donetsss/kicad-base/(commit log)

2020-02-10 Added new mounting hole footprints.
2020-02-19 Added new capacitor library.
2020-02-19 Added TH 1mm test point.
2020-02-20 Changed polarity capacitor symbol.
2020-02-20 Added NSD05-12S5 meanwell power module.
2020-02-20 Changed connectors.
2020-02-21 Added analog ground.
2020-02-21 Added THP-4MR connector.
2020-02-23 Added Bourns 3329H potentiometer's footprint.
2020-03-07 New footprints added.
2020-04-01 Added WF-2 WF-3 connectors.
2020-04-01 Added new pin header and socket connectors.
2020-04-01 Added new mechanical holes.
2020-04-06 Added bom list libreoffice templates https://blog.radiotech.kz/programmy/generaciya-perechnya-ehlementov-v-kicad-po-gost/
2020-04-06 Added new axial capacitor.
2020-04-07 Added fuse.
2020-05-07 Added HMC221B RF Switch.
2020-05-07 Added STM32F103C8T6 MCU.
2020-05-16 Added DIN 41612 connector type B.
2020-06-05 Added mosfet library.
2020-12-04 Added USB_B_Micro connector reference.
2020-12-30 Added 2x06 pin header.
2022-03-07 Added all modified files for Kicad 5.
2022-03-07 Migrate to a new file format of kicad 6.
2023-06-22 Added WJ126-5.0R connectors.
2023-07-04 Added ningbo xy2500v-e-3.81-2p and xy2500v-e-3.81-3p connectors. Added jst xh-b4b and xh-s4b connectors.
2023-07-19 Added FS8205A double N type mosfet in TSSOP8.
2023-07-19 Added DW01A power protection unit for battery management systems.
2023-08-03 Added B4B-XH from JST connectors.
2023-08-12 Change STM32F407VG sch ref.
2023-10-07 Added NAIS DSP1 relay.
2023-10-07 Some changes in lqfp-100 footprint.
2023-10-07 Added MELF diode footprint like SM4007 or other.
2023-10-07 Added Q_NMOS_GDS schematic symbol.
2023-10-07 Added SOIC254P1016X460-4N footprint w/3dmodel SFH6186.
2023-10-08 Added SW_DIP_04 schematic symbol and 76HPSB04GW dip switch footprint with 3d model.
2023-10-09 Added 74HC14 schematic symbol and soic-14 footprint.
2023-10-09 Added 74HC157 and soic-16 footprint.
2023-10-10 Edit SMB footprint.
2023-10-11 Added TerminalBlock_12_Male schematic symbol and PhoenixContact_GMSTBA_2,5_12-G_1x12_P7.50mm_Horizontal.
2023-10-12 Added C1812 capacitor footprint.
2023-10-12 Added diode in sot-23 schematic symbol.
2023-10-12 Added 1x06 male pin header.
2023-10-23 Added MMA0204 mini melf resistor footprint.
2023-10-23 Fixed hole's dia in idc header.
2023-12-29 Add 6032 tantalum capacitor footprint.
2024-01-09 Add TO-263-3_D2PAK footprint.
