donetsss/kicad-base/(notices)

Notices in the files:
plugins/InteractiveHtmlBom/InteractiveHtmlBom/core/newstroke_font.py:
modify it under the terms of the GNU General Public License
along with this program; if not, you may find one here:
http://www.gnu.org/licenses/old-licenses/gpl-2.0.html
